serg987/PWMtoRGB/(commit log)

2021-08-16 First working state - PWM and rainbow coloring
2021-08-23 Ready for test on real device
2021-09-07 Fix bug with PWM 3 high on 0; invert DC voltage; ready for flashing in device
    [main.c, rgbPwm.h]
2021-12-23 Add schematic diagram; hex file; edit readme
